ForwardCom/softcoreA/manual/README.md

# Manual for ForwardCom softcore model A

##

Files included |  Description
--- | ---
softcore_A.pdf   |   Manual and documentation for softcore
softcore_A.tex    |   Latex source for the manual
SchematicDebugButtons.png  |  Diagram for connecting pushbuttons
SchematicLCDdisplay.png  |  Diagram for connecting LCD display
LCDboard.jpg  |  Photo of debug add-on board
LCDboardApart.jpg  |  Photo of debug add-on board partially apart
